vojtechkral/nixie-clock/doc/IN-19A_IN-19B_IN-19V.pdf

www.tube-tester.com

File created by Dieter Waechter

# Dieter’s Nixie Tube Data Archive

This file is a part of Dieter's Nixie- and display tubes data archive

If you have more datasheets, articles, books, pictures or other information about Nixie tubes or other display devices please let me know. Thank you!

Document in this file | Reflector (Sovtek) – IN-19-tube types (ИН-19) – original datasheet
Display devices in this document | IN-19A, IN-19B, IN-19V (ИН-19A, ИН-19Б, ИН-19B)

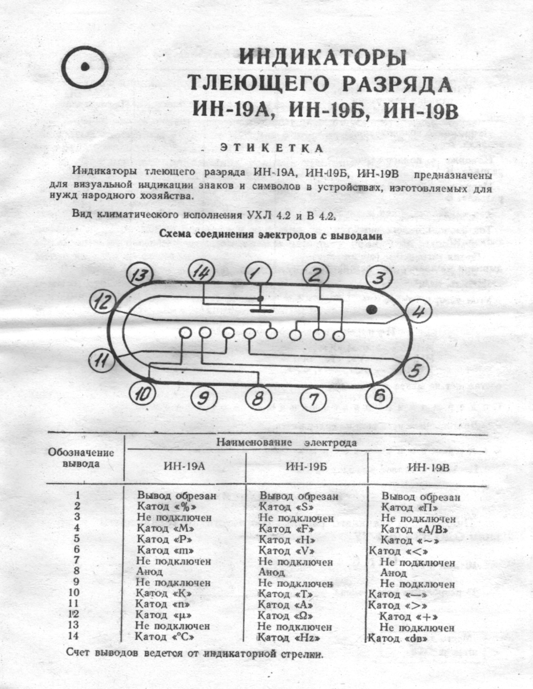
[picture p1: page 2]
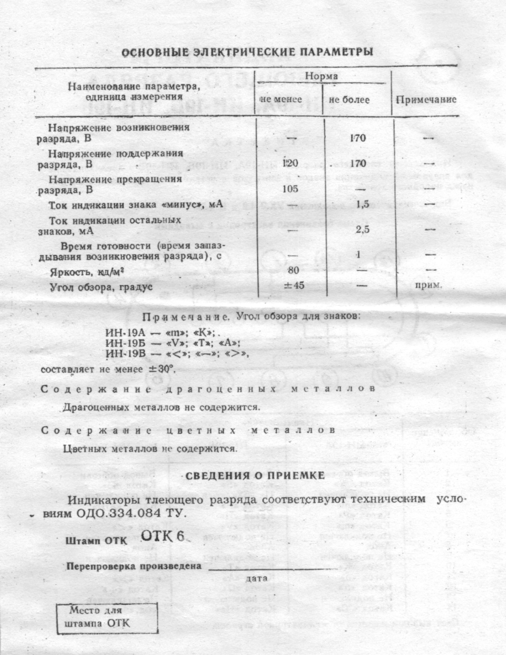
[picture p2: page 3]
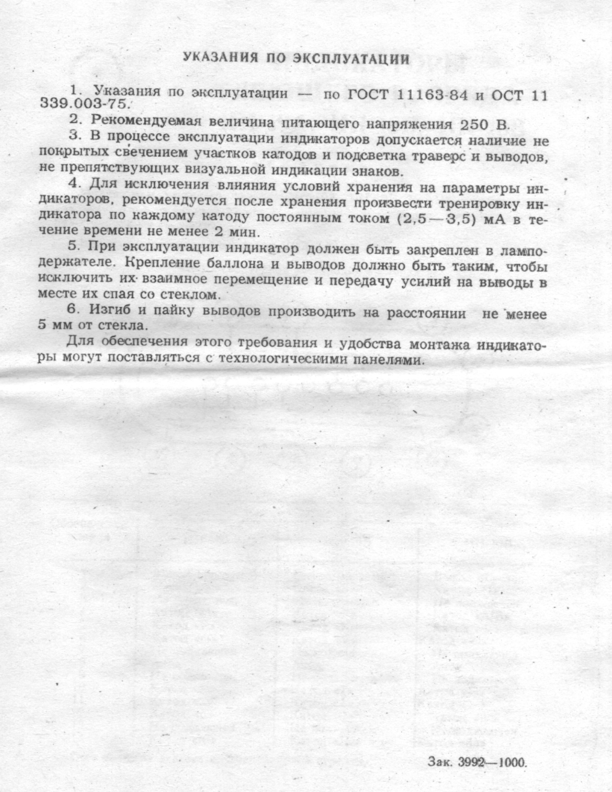
[picture p3: page 4]
