vojtechkral/nixie-clock/cad/nixie.png

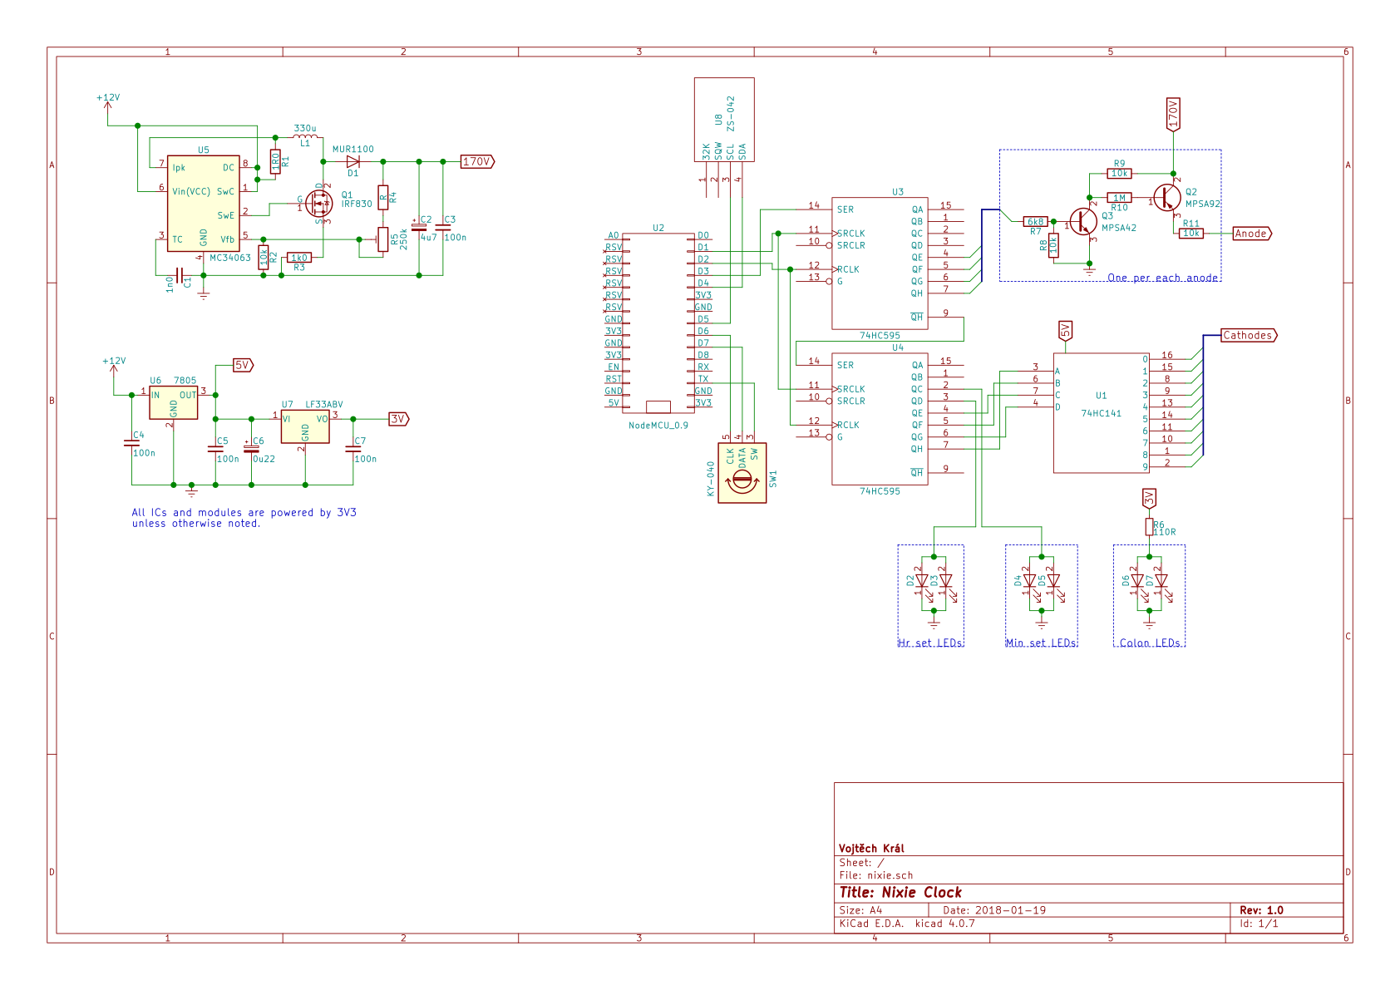
cad/nixie.png
