vojtechkral/nixie-clock/case/preview.png

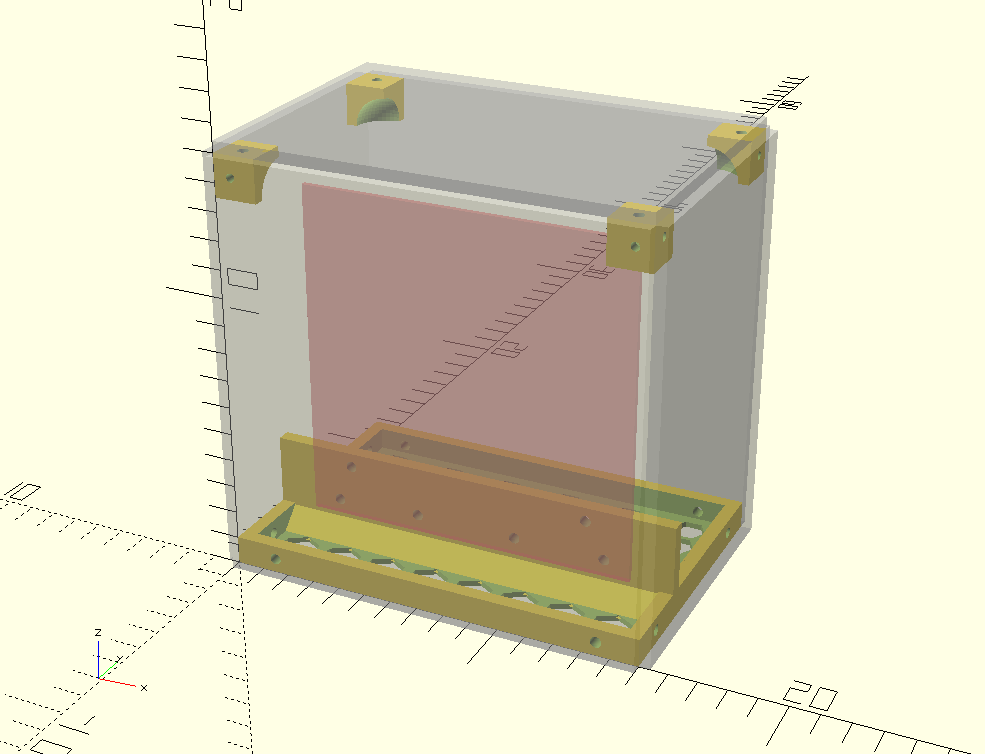
case/preview.png
