vojtechkral/nixie-clock/doc/mh74141_pinout.jpg

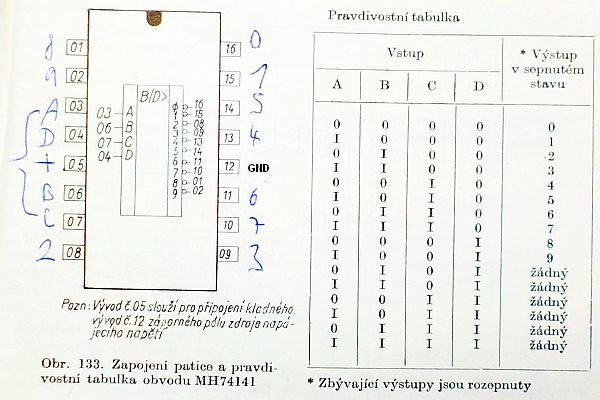
doc/mh74141_pinout.jpg
