vojtechkral/nixie-clock/case/base.stl

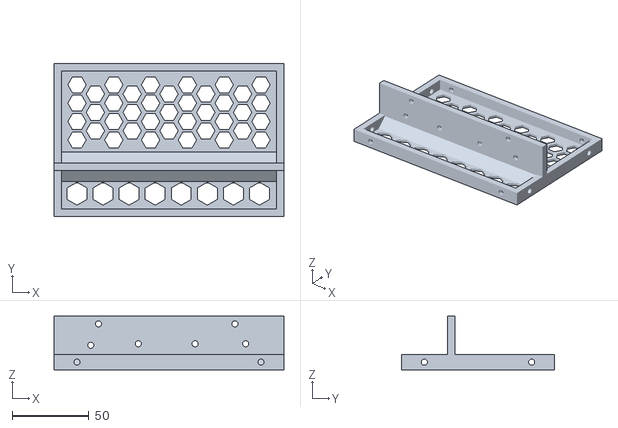
[picture p16: CAD file, 2018-01-09]
case/base.stl
150.0 x 100.0 x 35.0
