vojtechkral/nixie-clock/case/corner.stl

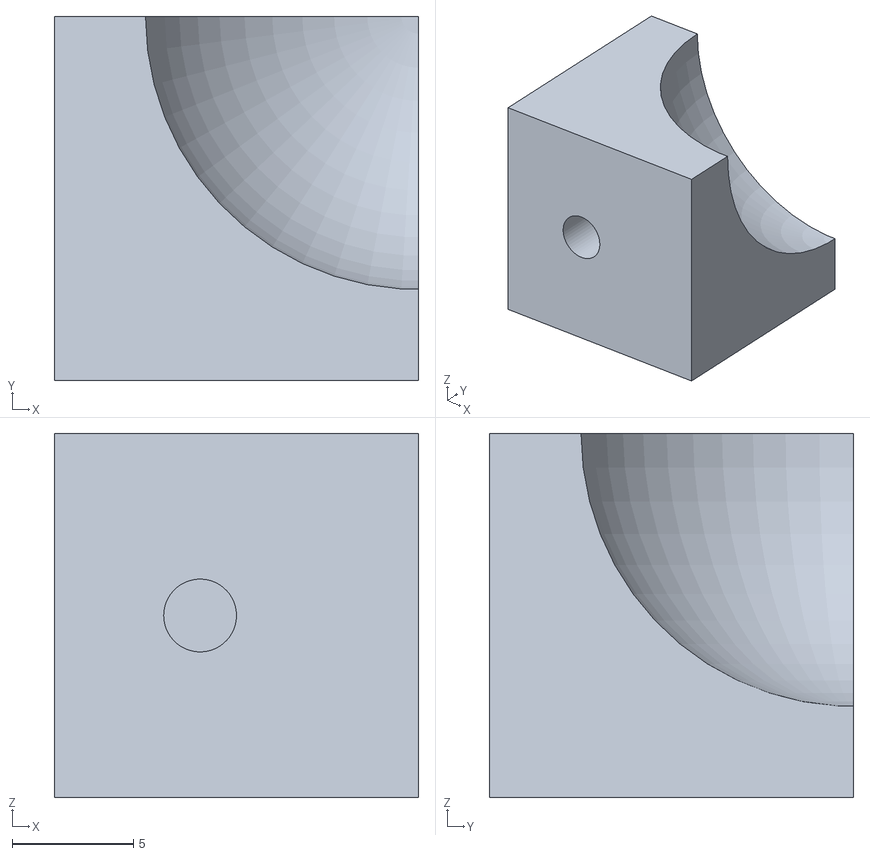
[picture p17: CAD file, 2018-01-09]
case/corner.stl
15.0 x 15.0 x 15.0
