vojtechkral/nixie-clock/cad/nixie-bw.pdf

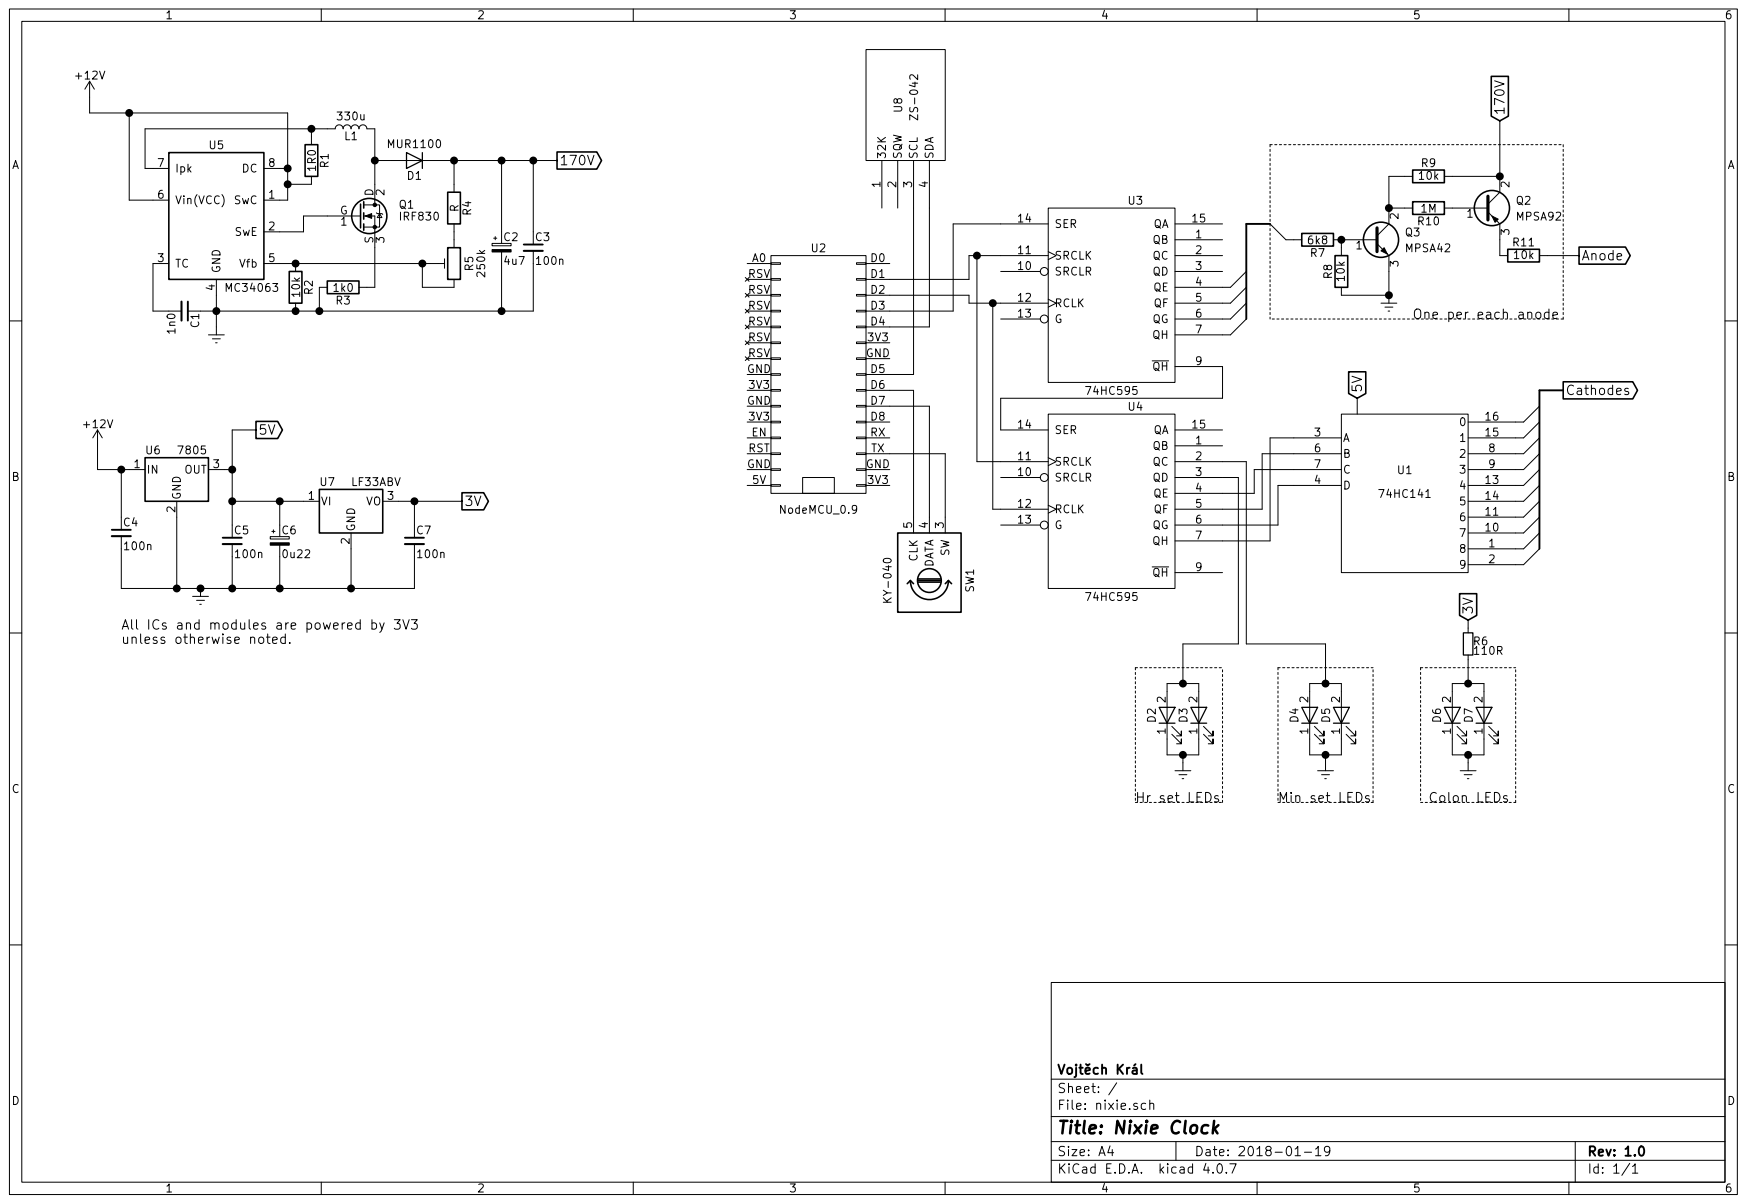
[picture p18: page 1]
