vojtechkral/nixie-clock/cad/nixie.pdf

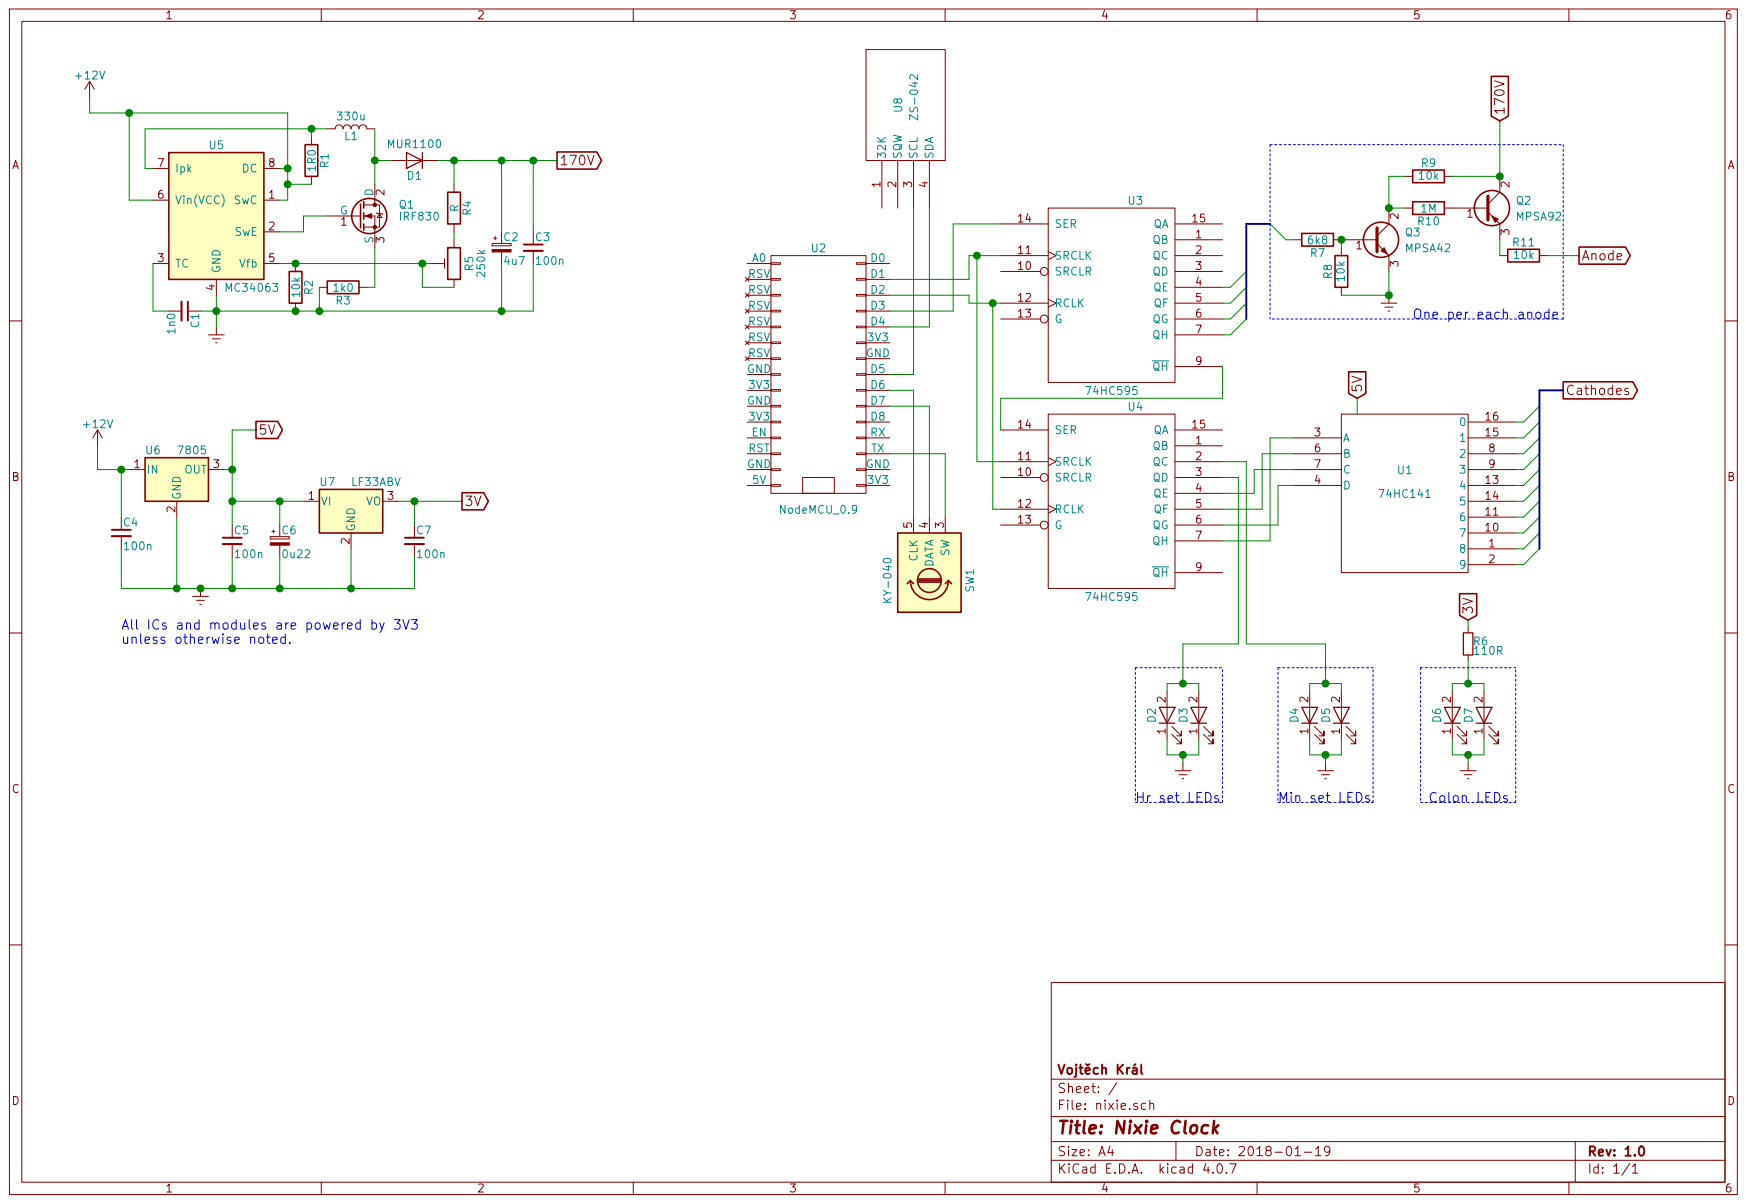
[picture p19: page 1]
