vojtechkral/nixie-clock/cad/nixie.sch

## KiCad design cad/nixie.sch (2018-01-21)

Schematic: nixie.sch

Parts:
250k: R5
C1: 1n0
C2: 4u7
C3, C4, C5, C7: 100n
C6: 0u22
D1: MUR1100
D2, D3, D4, D5, D6, D7: (no value)
L1: 330u
Q1: IRF830; TO-220_Vertical
Q2: MPSA92
Q3: MPSA42
R1: 1R0
R2, R8, R9, R11: 10k
R3: 1k0
R4: R
R6: 110R
R7: 6k8
R10: 1M
SW1: KY-040
U1: 74HC141
U2: NodeMCU_0.9
U3, U4: 74HC595
U5: MC34063
U6: 7805
U7: LF33ABV; TO-220_Vertical
U8: ZS-042

Notes on the sheet:
One per each anode
Hr set LEDs
Min set LEDs
Colon LEDs
All ICs and modules are powered by 3V3 unless otherwise noted.
