vojtechkral/nixie-clock/(commit log)

2018-01-09 NodeMCU pin convenience macros
2018-01-09 GPIO interrupt WIP
2018-01-09 Prevent rapid state changes
    [user_main.c]
2018-01-09 Add 3D models for a case
    [base.scad, base.stl, case.scad, corner.scad, corner.stl]
2018-01-09 Update base, doc
    [base.scad, base.stl, case.scad]
2018-01-09 Dir structure cleanup
    [base.scad, base.stl, case.scad, corner.scad, corner.stl]
2018-01-09 Add case preview
2018-01-19 Add circuit schematics
    [nixie.sch]
2018-01-21 Fix minor bugs in schematics
    [nixie.sch]
